Leander-D14/Dual-IMU-Haptic-Monitor-for-Genu-Recurvatum/Media/Poster_Genu-recurvatum.pdf

# A Dual-IMU Haptic Monitor for Post-Stroke Genu Recurvatum Correction

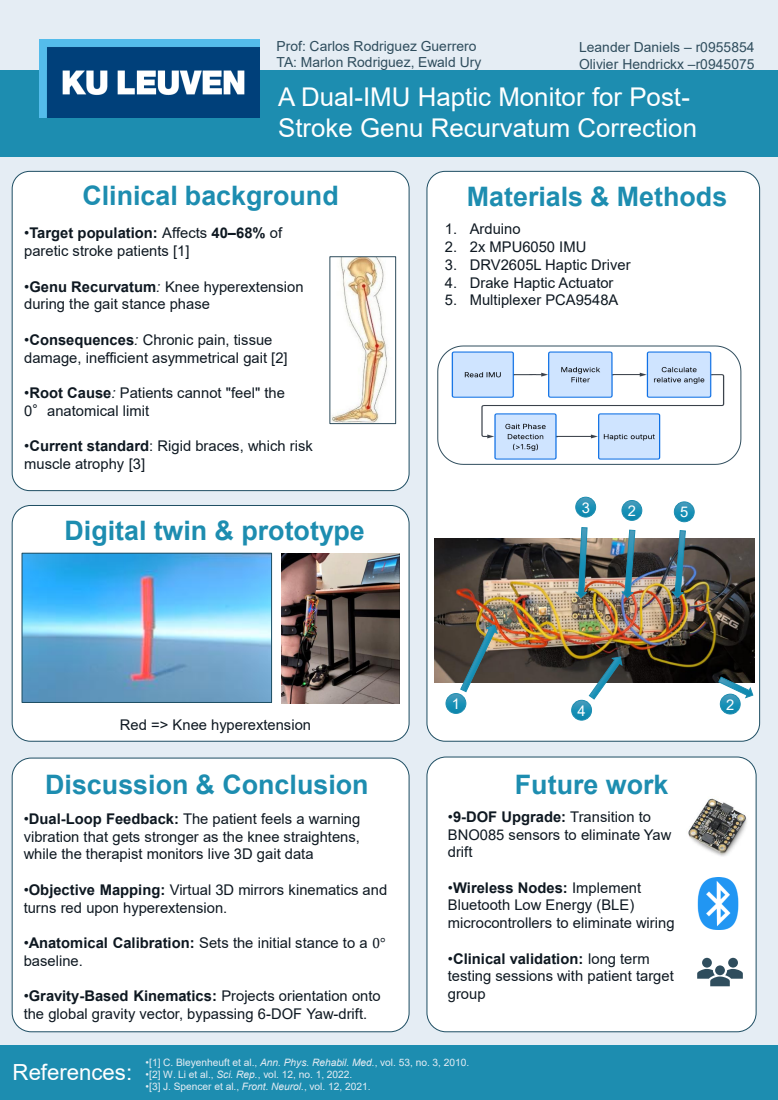
[picture p5: page 1]
Leander Daniels – r0955854 Olivier Hendrickx –r0945075; References:; Clinical background; Materials & Methods; Discussion & Conclusion; Future work

Prof: Carlos Rodriguez Guerrero
TA: Marlon Rodriguez, Ewald Ury

1. Arduino
2. 2x MPU6050 IMU
3. DRV2605L Haptic Driver
4. Drake Haptic Actuator
5. Multiplexer PCA9548A

•Target population: Affects 40–68% of
paretic stroke patients [1]

•Genu Recurvatum: Knee hyperextension
during the gait stance phase

•Consequences: Chronic pain, tissue
damage, inefficient asymmetrical gait [2]

•Root Cause: Patients cannot "feel" the
0°anatomical limit

•Current standard: Rigid braces, which risk
muscle atrophy [3]

Digital twin & prototype

Red => Knee hyperextension

•Dual-Loop Feedback: The patient feels a warning
vibration that gets stronger as the knee straightens,
while the therapist monitors live 3D gait data

•9-DOF Upgrade: Transition to
BNO085 sensors to eliminate Yaw
drift

•Wireless Nodes: Implement
Bluetooth Low Energy (BLE)
microcontrollers to eliminate wiring

•Objective Mapping: Virtual 3D mirrors kinematics and
turns red upon hyperextension.

•Anatomical Calibration: Sets the initial stance to a 0°
baseline.

•Clinical validation: long term
testing sessions with patient target
group

•Gravity-Based Kinematics: Projects orientation onto
the global gravity vector, bypassing 6-DOF Yaw-drift.

•[1] C. Bleyenheuft et al., Ann. Phys. Rehabil. Med., vol. 53, no. 3, 2010.
•[2] W. Li et al., Sci. Rep., vol. 12, no. 1, 2022.
•[3] J. Spencer et al., Front. Neurol., vol. 12, 2021.
