Leander-D14/Dual-IMU-Haptic-Monitor-for-Genu-Recurvatum/(commit log)

2026-05-15 Arduino + Unity code V1
2026-05-27 Arduino code with queternion logic Unity updated to new arduino code + new customization features
2026-05-29 Added numbering to breadbord wiring
